stupnd/Bridge/(commit log)

2026-02-04 Initialize ASL Glove Sensor Dashboard project with essential files. Added .gitignore, package.json, and package-lock.json for dependency management. Created main application structure including App.j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
2026-02-24 Create test script for BLE communication between ESP32 and Laptop
2026-02-25 Updated ESP32 sample program
2026-02-27 Add Sensor page and FlexSensor component for ESP32 glove connectivity
    - Introduced a new Sensor page to the routing structure.
    - Added FlexSensor component to handle Bluetooth connectivity and display flex values.
    - Updated Layout component to include navigation for the new Sensor page.
2026-02-27 Add BLE functionality for FlexSensor in ESP32 project
    - Created a new flex.ino file to implement Bluetooth Low Energy (BLE) service for the FlexSensor.
    - Set up BLE characteristics to read and notify flex sensor values.
    - Integrated analog reading of flex values and established BLE advertising for connectivity.
    [flex.ino]
2026-03-13 Uploaded working code for the 9-axis sensor
    It prints the numbers.
2026-03-18 Update ESP32 code to transmit sensor data
    Also updated test_script.py to read the data
2026-03-26 Add flex sensor BLE integration and calibration UI
2026-03-27 Add .env to .gitignore and update package dependencies
    - Added .env to .gitignore to prevent sensitive information from being tracked.
    - Updated frontend package-lock.json and package.json to include new dependencies for Supabase and TypeScript types.
    - Enhanced FlexSensor component with gesture recognition and calibration features, including loading profiles from Supabase.
    - Introduced new utility functions for gesture classification and sample collection.
2026-04-02 Update package dependencies and enhance FlexSensor calibration features
    - Added new dependencies for Supabase and TypeScript types in package.json.
    - Updated package-lock.json to reflect changes in dependencies.
    - Enhanced FlexSensor component with improved calibration functionality, including saving and loading calibration data, and user feedback for calibration steps.
    - Introduced a new HandVisualizer route for better integration with the calibration process.
2026-04-07 Refactor sensor integration and enhance user authentication
    - Updated supabaseClient to use hardcoded Supabase URL and key for testing.
    - Introduced ProtectedRoute component to manage user authentication and access control.
    - Integrated SensorContext for managing sensor state and connectivity across components.
    - Enhanced FlexSensor and HandVisualizer components to utilize context for sensor data.
    - Updated Dashboard and Login components to support user authentication with Supabase.
    - Improved gesture recognition logic and calibration handling in the Dashboard component.
2026-04-13 Refactor to use finger sensors and remove IMU code
    Removed ICM-20948 sensor initialization and related code. Added analog readings for finger sensors instead.
2026-09-18 Improve 9-axis test sketch with I2C scan and column output
    Scans the I2C bus on boot to surface wiring problems, tries both
    ICM-20948 addresses (AD0=0/1), and prints one tab-aligned row per
    sample instead of four lines.
    [9-axis-test.ino]
2026-09-27 Set up the Raspberry Pi, added a test script for text-to-speech
    See setup instructions and package-export for usage instructions.
2026-10-16 Collect page: frame-by-frame recording for all sign types, CSV export, IndexedDB autosave
    - SensorContext parses IMU + flex from every packet and exposes subscribe() for per-frame capture
    - DataCollector drops Supabase; adds hand toggle, free-text label, Static/Moving/None types with editable window, countdown + progress, per-sample rate/IMU warnings, delete-last
    - Long-format frames CSV (R_/L_ columns) plus per-session calibration CSV
    - Autosave to IndexedDB with restore on load; dev-only glove simulator at 50 Hz
2026-10-23 Stream 9-axis data from the glove and add IMU test tools
    - Main firmware sends flex + ICM-20948 readings in one 56-byte BLE packet at ~50 Hz
    - Pinky moved to D2 (ADC1) to avoid ADC2 noise while BLE is on
    - IMU auto-detects its I2C address and reconnects if it drops out
    - Add a browser visualizer for the 9-axis test sketch
    - Add a two-hand IMU sketch and an I2C wiring check sketch
2026-10-23 Learn letter recognition from samples and add a Lab page
    - Replace hard-coded finger rules with a nearest-neighbour model trained
    on recorded samples (bundled asl-samples.csv); recognizes all 24 static letters
    - Translate and Learn practice use the shared model, with confidence and hints
    - New Lab page: virtual glove sliders, live glove input, prediction breakdown,
    editable training data (add sample, CSV import/export) and a robustness test
    - Restructure the app into Translate, Learn, Glove, Collect and Lab pages
2026-10-23 Smooth predictions, flag unsure letters, and add guided hand recording
    - Translate and Learn vote over the last 300 ms so the letter doesn't flicker
    - Report "unsure" (e.g. "E or S?") instead of typing when the two closest
    letters are too alike; threshold adjustable in the Lab
    - Lab imports the Collect page's frames CSV and its saved samples directly
    - "Teach it your hand": guided recording of every static letter for the wearer
    - Robustness test separates wrong letters from unsure/no-letter results
2026-10-23 Replace prototype Supabase tables with a team-only recordings dataset
    - Migrations for team_members, recording_sessions and recordings with
    row-level security: signed-out visitors see nothing, team members read
    everything and write only their own rows
    - Collect uploads each sample to the team dataset and retries anything pending
    - Lab can train on the whole team's recordings
    - Typed Supabase client generated from the schema
2026-11-06 Redesign the frontend: new landing page, login, and app pages
    Adds a landing page, wordmark, and team roadmap page, and restyles login,
    translate, learn, collect, lab, glove, and profile around a shared theme.
